jwhitham/spdif-bit-exactness-tools/img/diagram1.jpg

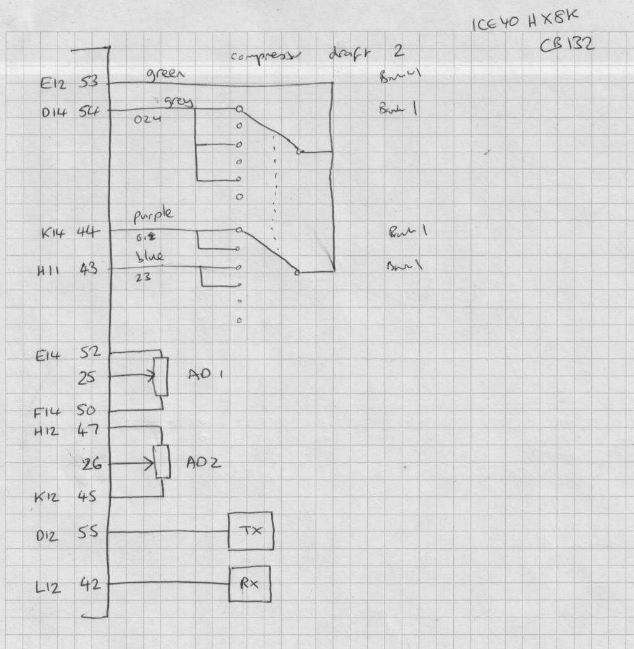
img/diagram1.jpg
