jwhitham/spdif-bit-exactness-tools/img/diagram2.jpg

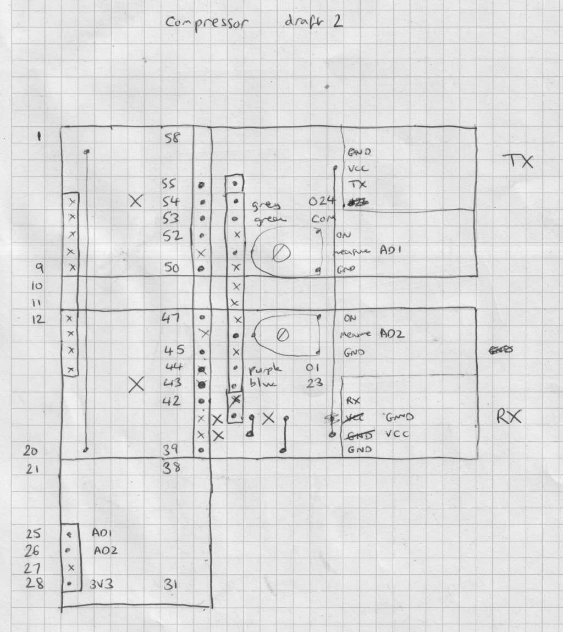
img/diagram2.jpg
