jwhitham/spdif-bit-exactness-tools/img/fpga.jpg

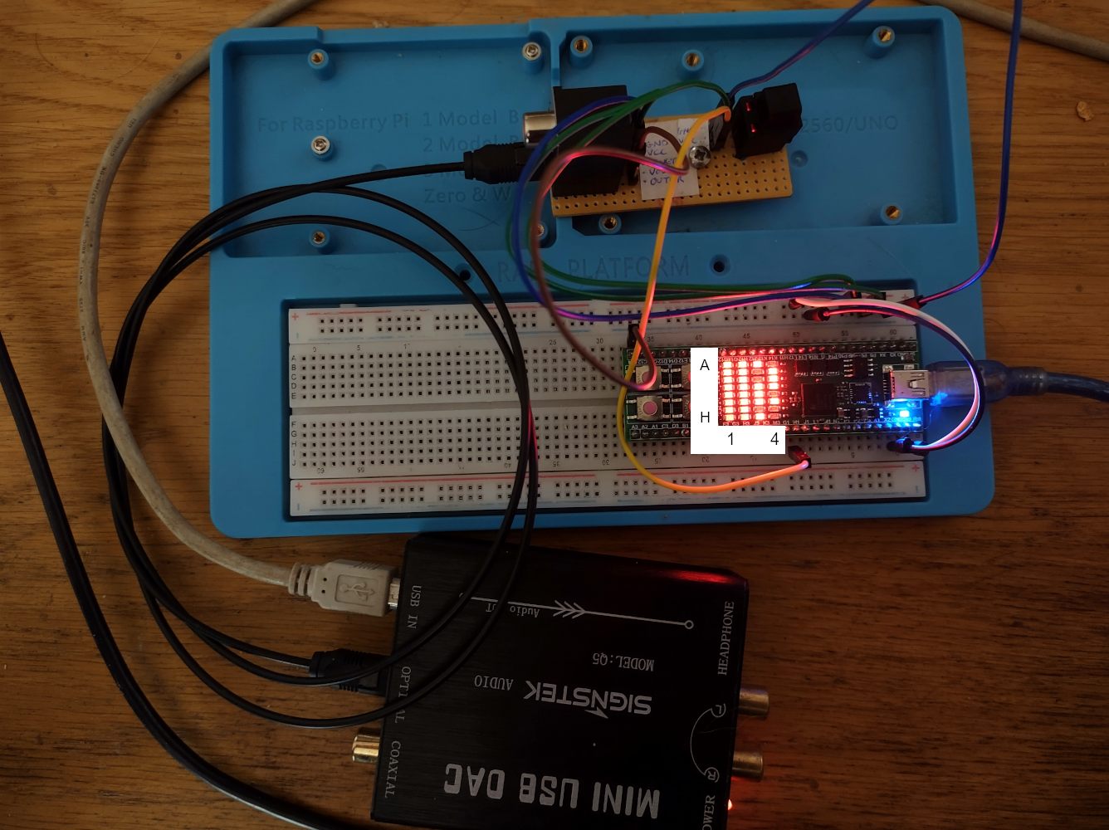
img/fpga.jpg
