jwhitham/spdif-bit-exactness-tools/fpga/test/test_top_level_out.txt

Start of ../examples/20220502-32k.csv
second matcher desynchronised
second channel decoder desynchronised
second packet decoder desynchronised
second input decoder desynchronised
combined encoder desynchronised
clock regenerator desynchronised
matcher desynchronised
channel decoder desynchronised
packet decoder desynchronised
input decoder desynchronised
input decoder single time = 0
input decoder synchronised
input decoder single time = 44
packet decoder synchronised
input decoder desynchronised
input decoder single time = 0
packet decoder desynchronised
input decoder synchronised
input decoder single time = 12
packet decoder synchronised
packet decoder desynchronised
packet decoder synchronised
channel decoder synchronised
000000 cfb500
input decoder desynchronised
input decoder single time = 0
packet decoder desynchronised
channel decoder desynchronised
Start of ../examples/20220502-44k.csv
input decoder synchronised
input decoder single time = 40
packet decoder synchronised
input decoder desynchronised
input decoder single time = 0
packet decoder desynchronised
input decoder synchronised
input decoder single time = 9
packet decoder synchronised
packet decoder desynchronised
input decoder desynchronised
input decoder single time = 0
Start of ../examples/20220502-48k.csv
input decoder synchronised
input decoder single time = 40
packet decoder synchronised
input decoder desynchronised
input decoder single time = 0
packet decoder desynchronised
input decoder synchronised
input decoder single time = 8
packet decoder synchronised
channel decoder synchronised
000000 000000
000000 000000
input decoder desynchronised
input decoder single time = 0
packet decoder desynchronised
channel decoder desynchronised
Start of ../examples/test_48000_24_bit.csv
input decoder synchronised
input decoder single time = 39
packet decoder synchronised
input decoder desynchronised
input decoder single time = 0
packet decoder desynchronised
input decoder synchronised
input decoder single time = 6
packet decoder synchronised
packet decoder desynchronised
input decoder desynchronised
input decoder single time = 0
input decoder synchronised
input decoder single time = 9
packet decoder synchronised
channel decoder synchronised
001000 ffefff
002000 ffdfff
004000 ffbfff
008000 ff7fff
010000 feffff
020000 fdffff
040000 fbffff
080000 f7ffff
clock regenerator synchronised
combined encoder synchronised
100000 efffff
second input decoder synchronised
second packet decoder synchronised
second input decoder desynchronised
second packet decoder desynchronised
200000 dfffff
second input decoder synchronised
second packet decoder synchronised
second channel decoder synchronised
400000 bfffff
800000 7fffff
01e000 654321
c64e00 655e00
257600 7d5600
f66900 51f300
b61800 1d7600
4dc100 db5e00
40d900 9e0d00
508a00 48dd00
e3b30d 0c8faf
afe65e 4195b3
667001 40817f
24daf1 ebf8c9
5a20c9 75c3ea
d0961c 8de3b3
8fb408 cfb555
ea6d66 3e4874
000001 fffffe
000002 fffffd
000004 fffffb
000008 fffff7
000010 ffffef
000020 ffffdf
000040 ffffbf
000080 ffff7f
000100 fffeff
000200 fffdff
000400 fffbff
000800 fff7ff
001000 ffefff
002000 ffdfff
004000 ffbfff
008000 ff7fff
010000 feffff
input decoder desynchronised
input decoder single time = 0
packet decoder desynchronised
channel decoder desynchronised
clock regenerator desynchronised
combined encoder desynchronised
second input decoder desynchronised
second packet decoder desynchronised
second channel decoder desynchronised
Start of ../examples/test_44100_24_bit.csv
input decoder synchronised
input decoder single time = 39
packet decoder synchronised
input decoder desynchronised
input decoder single time = 0
packet decoder desynchronised
input decoder synchronised
input decoder single time = 7
input decoder single time = 9
packet decoder synchronised
channel decoder synchronised
020000 db5e00
40d900 9e0d00
508a00 48dd00
e3b30d 0c8faf
afe65e 4195b3
667001 40817f
24daf1 ebf8c9
5a20c9 75c3ea
clock regenerator synchronised
d0961c 8de3b3
combined encoder synchronised
8fb408 cfb555
second input decoder synchronised
second packet decoder synchronised
second input decoder desynchronised
second packet decoder desynchronised
ea6d66 3e4874
second input decoder synchronised
second packet decoder synchronised
second channel decoder synchronised
000001 fffffe
000002 fffffd
000004 fffffb
000008 fffff7
000010 ffffef
000020 ffffdf
000040 ffffbf
000080 ffff7f
000100 fffeff
000200 fffdff
000400 fffbff
000800 fff7ff
001000 ffefff
002000 ffdfff
004000 ffbfff
008000 ff7fff
010000 feffff
020000 fdffff
040000 fbffff
080000 f7ffff
100000 efffff
200000 dfffff
400000 bfffff
800000 7fffff
01b900 654321
c64e00 655e00
257600 7d5600
f66900 51f300
b61800 1d7600
input decoder desynchronised
input decoder single time = 0
packet decoder desynchronised
channel decoder desynchronised
clock regenerator desynchronised
combined encoder desynchronised
second input decoder desynchronised
second packet decoder desynchronised
second channel decoder desynchronised
Start of test/test_44100_data with quality = Quality.EXACT_24
input decoder synchronised
input decoder single time = 41
packet decoder synchronised
input decoder single time = 40
input decoder desynchronised
input decoder single time = 0
packet decoder desynchronised
input decoder synchronised
input decoder single time = 8
packet decoder synchronised
channel decoder synchronised
000004 fffffb
000008 fffff7
000010 ffffef
000020 ffffdf
000040 ffffbf
000080 ffff7f
000100 fffeff
000200 fffdff
clock regenerator synchronised
combined encoder synchronised
000400 fffbff
second input decoder synchronised
second packet decoder synchronised
second input decoder desynchronised
second packet decoder desynchronised
000800 fff7ff
second input decoder synchronised
second packet decoder synchronised
second channel decoder synchronised
001000 ffefff
002000 ffdfff
004000 ffbfff
008000 ff7fff
010000 feffff
020000 fdffff
040000 fbffff
080000 f7ffff
100000 efffff
200000 dfffff
400000 bfffff
800000 7fffff
01b900 654321
c64e00 655e00
257600 7d5600
f66900 51f300
b61800 1d7600
4dc100 db5e00
40d900 9e0d00
508a00 48dd00
e3b30d 0c8faf
afe65e 4195b3
667001 40817f
24daf1 ebf8c9
5a20c9 75c3ea
d0961c 8de3b3
8fb408 cfb555
ea6d66 3e4874
000001 fffffe
000002 fffffd
000004 fffffb
000008 fffff7
000010 ffffef
000020 ffffdf
000040 ffffbf
000080 ffff7f
000100 fffeff
000200 fffdff
000400 fffbff
000800 fff7ff
001000 ffefff
002000 ffdfff
004000 ffbfff
008000 ff7fff
010000 feffff
020000 fdffff
040000 fbffff
080000 f7ffff
100000 efffff
200000 dfffff
400000 bfffff
800000 7fffff
matcher sample rate = 44100 sync4 = 3
matcher synchronised
second matcher synchronised
01b900 654321
c64e00 655e00
257600 7d5600
f66900 51f300
b61800 1d7600
4dc100 db5e00
40d900 9e0d00
508a00 48dd00
e3b30d 0c8faf
afe65e 4195b3
667001 40817f
24daf1 ebf8c9
5a20c9 75c3ea
d0961c 8de3b3
8fb408 cfb555
ea6d66 3e4874
000001 fffffe
000002 fffffd
000004 fffffb
000008 fffff7
000010 ffffef
000020 ffffdf
000040 ffffbf
000080 ffff7f
000100 fffeff
000200 fffdff
000400 fffbff
000800 fff7ff
001000 ffefff
002000 ffdfff
004000 ffbfff
008000 ff7fff
010000 feffff
020000 fdffff
040000 fbffff
080000 f7ffff
100000 efffff
200000 dfffff
400000 bfffff
800000 7fffff
01b900 654321
c64e00 655e00
257600 7d5600
f66900 51f300
b61800 1d7600
4dc100 db5e00
40d900 9e0d00
508a00 48dd00
e3b30d 0c8faf
afe65e 4195b3
667001 40817f
24daf1 ebf8c9
5a20c9 75c3ea
d0961c 8de3b3
8fb408 cfb555
ea6d66 3e4874
000001 fffffe
000002 fffffd
000004 fffffb
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
second packet decoder desynchronised
second input decoder desynchronised
combined encoder desynchronised
clock regenerator desynchronised
matcher desynchronised
channel decoder desynchronised
packet decoder desynchronised
input decoder single time = 0
input decoder desynchronised
