jwhitham/spdif-bit-exactness-tools/examples/test_44100_24_bit.csv

Time | Channel A
(ms) | (mV)
-0.00020594 | 64.21705000
-0.00012594 | 3.17697700
-0.00004594 | -5.79851700
0.00003406 | 50.75228000
0.00011406 | 63.31981000
0.00019406 | 65.11430000
0.00027406 | 64.21705000
0.00035406 | 43.56823000
0.00043406 | -2.20954000
0.00051406 | -5.79851700
0.00059406 | -6.69576100
0.00067406 | -8.49330100
0.00075406 | 53.44401000
0.00083406 | 64.21705000
0.00091406 | 64.21705000
0.00099406 | 64.21705000
0.00107406 | 23.81970000
0.00115406 | -5.79851700
0.00123406 | -3.10678400
0.00131406 | 60.62502000
0.00139406 | 64.21705000
0.00147406 | 2.27973300
0.00155406 | -5.79851700
0.00163406 | -6.69576100
0.00171406 | -7.59605700
0.00179406 | 35.48997000
0.00187406 | 63.31981000
0.00195406 | 65.11430000
0.00203406 | 65.11430000
0.00211406 | 65.11430000
0.00219406 | 65.11430000
0.00227406 | 65.11430000
0.00235406 | 3.17697700
0.00243406 | -5.79851700
0.00251406 | -6.69576100
0.00259406 | -7.59605700
0.00267406 | -7.59605700
0.00275406 | -7.59605700
0.00283406 | 13.94696000
0.00291406 | 60.62502000
0.00299406 | 64.21705000
0.00307406 | -3.10678400
0.00315406 | -5.79851700
0.00323406 | 53.44401000
0.00331406 | 64.21705000
0.00339406 | 65.11430000
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
