jwhitham/spdif-bit-exactness-tools/fpga/app/rotary_switch.vhdl

-- Decode a 6-way double pole rotary switch which can be overridden by buttons.
-- The rotary switch
-- to obtain a number from 000 to 101.
-- Buttons may also be used to temporarily override the rotary switch.

library work;
use work.all;

library ieee;
use ieee.std_logic_1164.all;
use ieee.numeric_std.all;

entity rotary_switch is
    port (
        clock_in            : in std_logic;
        reset_in            : in std_logic;
        pulse_100hz_in      : in std_logic;
        rotary_024          : in std_logic; -- grey wire
        rotary_01           : in std_logic; -- purple wire
        rotary_23           : in std_logic; -- blue wire
        left_button         : in std_logic;
        right_button        : in std_logic;
        strobe_out          : out std_logic := '0';
        value_out           : out mode_definitions.t_mode := mode_definitions.min_value;
        com_mode_value_in   : in mode_definitions.t_mode;
        com_mode_set_in     : in std_logic;
        com_mode_clear_in   : in std_logic);
end rotary_switch;

architecture structural of rotary_switch is

    -- Signals must be stable for 10 - 20ms to be recognised as valid
    constant max_countdown  : Natural := 2;
    subtype t_countdown is Natural range 0 to max_countdown;
    subtype t_button is std_logic_vector (1 downto 0);

    -- Registers
    signal countdown        : t_countdown := max_countdown;
    signal code             : std_logic_vector (2 downto 0) := (others => '0');
    signal updated_buttons  : std_logic := '0';
    signal updated_rotary   : std_logic := '0';
    signal new_button_value : t_button := "00";
    signal new_rotary_value : mode_definitions.t_mode := mode_definitions.min_value;
    signal old_button_value : t_button := "00";
    signal old_rotary_value : mode_definitions.t_mode := mode_definitions.min_value;
    signal output_value     : mode_definitions.t_mode := mode_definitions.min_value;

    -- Signals

begin
    register_inputs : process (clock_in)
    begin
        if clock_in'event and clock_in = '1' then
            code (0) <= rotary_024;
            code (1) <= rotary_01;
            code (2) <= rotary_23;
            new_button_value (1) <= not left_button;   -- buttons are active low
            new_button_value (0) <= not right_button;
        end if;
    end process register_inputs;

    decode_inputs : process (clock_in)
    begin
        if clock_in'event and clock_in = '1' then
            case code is
                when "100" =>  new_rotary_value <= mode_definitions.COMPRESS_MAX; -- rotary_01 low: rotary_value is 0
                when "101" =>  new_rotary_value <= mode_definitions.COMPRESS_2;   --                rotary_value is 1
                when "010" =>  new_rotary_value <= mode_definitions.COMPRESS_1;   -- rotary_23 low: rotary_value is 2
                when "011" =>  new_rotary_value <= mode_definitions.ATTENUATE_2;  --                rotary_value is 3
                when "110" =>  new_rotary_value <= mode_definitions.COMPRESS_VIDEO; -- 01 / 23 high:rotary_value is 4
                when "111" =>  new_rotary_value <= mode_definitions.PASSTHROUGH;  --                rotary_value is 5
                when others => new_rotary_value <= mode_definitions.PASSTHROUGH;  -- invalid (both 01 and 23 are low)
            end case;
        end if;
    end process decode_inputs;

    await_stability : process (clock_in)
    begin
        if clock_in'event and clock_in = '1' then
            strobe_out <= '0';

            if reset_in = '1' then
                -- Don't trigger a mode change strobe when coming out of reset!
                -- Start up in the mode selected with the switch.
                updated_buttons <= '0';
                updated_rotary <= '0';
                old_button_value <= new_button_value;
                old_rotary_value <= new_rotary_value;
                output_value <= new_rotary_value;
                countdown <= max_countdown;

            elsif new_button_value /= old_button_value then
                countdown <= max_countdown;
                updated_buttons <= '1';
                old_button_value <= new_button_value;

            elsif new_rotary_value /= old_rotary_value then
                countdown <= max_countdown;
                updated_rotary <= '1';
                old_rotary_value <= new_rotary_value;

            elsif countdown /= 0 then
                if pulse_100hz_in = '1' then
                    countdown <= countdown - 1;
                end if;

            else
                if updated_buttons = '1' then
                    if new_button_value (1) = '1' then
                        -- left button: decrement
                        strobe_out <= '1';
                        if output_value /= mode_definitions.min_value then
                            output_value <= std_logic_vector (unsigned (output_value) - 1);
                        end if;
                    elsif new_button_value (0) = '1' then
                        -- right button: increment
                        strobe_out <= '1';
                        if output_value /= mode_definitions.max_value then
                            output_value <= std_logic_vector (unsigned (output_value) + 1);
                        end if;
                    end if;
                    updated_buttons <= '0';
                elsif updated_rotary = '1' or com_mode_clear_in = '1' then
                    -- go direct to current setting on the rotary switch
                    strobe_out <= '1';
                    output_value <= new_rotary_value;
                    updated_rotary <= '0';
                elsif com_mode_set_in = '1' then
                    -- Remote control set
                    strobe_out <= '1';
                    output_value <= com_mode_value_in;
                end if;
            end if;
        end if;
    end process await_stability;

    value_out <= output_value;

end architecture structural;
