jwhitham/spdif-bit-exactness-tools/fpga/comfilter/banked_shift_register.vhdl

library comfilter;
use comfilter.all;

library ieee;
use ieee.std_logic_1164.all;
use ieee.numeric_std.all;

use debug_textio.all;

entity banked_shift_register is
    generic (
        name          : String;
        size          : Natural;
        verbose_debug : Boolean := false);
    port (
        reg_out             : out std_logic := '0';
        negative_out        : out std_logic := '0';
        debug_out           : out std_logic_vector(size - 1 downto 0) := (others => '0');
        shift_right_in      : in std_logic := '0';
        bank_select_in      : in std_logic := '0';
        reg_in              : in std_logic := '0';
        clock_in            : in std_logic := '0');
end banked_shift_register;

architecture structural of banked_shift_register is
    signal reg_b0, negative_b0, shift_b0 : std_logic := '0';
    signal reg_b1, negative_b1, shift_b1 : std_logic := '0';
    signal debug_b0, debug_b1            : std_logic_vector(size - 1 downto 0) := (others => '0');
begin
    b0 : entity shift_register
        generic map (
            name => name & "_b0",
            size => size,
            verbose_debug => verbose_debug)
        port map (
            reg_out => reg_b0,
            negative_out => negative_b0,
            shift_right_in => shift_b0,
            debug_out => debug_b0,
            reg_in => reg_in,
            clock_in => clock_in);

    b1 : entity shift_register
        generic map (
            name => name & "_b1",
            size => size,
            verbose_debug => verbose_debug)
        port map (
            reg_out => reg_b1,
            negative_out => negative_b1,
            shift_right_in => shift_b1,
            debug_out => debug_b1,
            reg_in => reg_in,
            clock_in => clock_in);

    reg_out <= reg_b0 when bank_select_in = '0' else reg_b1;
    negative_out <= negative_b0 when bank_select_in = '0' else negative_b1;
    shift_b0 <= shift_right_in when bank_select_in = '0' else '0';
    shift_b1 <= shift_right_in when bank_select_in = '1' else '0';
    debug_out <= debug_b0 when bank_select_in = '0' else debug_b1;
end structural;
