jwhitham/spdif-bit-exactness-tools/fpga/test/test_compressor_main.vhdl

library work;
use work.all;

library ieee;
use ieee.std_logic_1164.all;
use ieee.numeric_std.all;

use debug_textio.all;

entity test_compressor_main is
end test_compressor_main;

architecture structural of test_compressor_main is

    signal clock           : std_logic := '0';
    signal raw_data        : std_logic := '0';
    signal done            : std_logic := '0';
    constant one           : std_logic := '1';
    constant zero          : std_logic := '0';
    signal lcols           : std_logic_vector (3 downto 0) := (others => '0');
    signal lrows           : std_logic_vector (7 downto 0) := (others => '0');

begin
    test_signal_gen : entity test_signal_generator
        port map (raw_data_out => raw_data, done_out => done, clock_out => clock);

    t : entity compressor_main
        port map (
            clock_in => clock,
            spdif_rx_in => raw_data,
            lcols_out => lcols,
            lrows_out => lrows,
            rx_from_pic_in => zero,
            rotary_024_in => one,
            rotary_01_in => one,
            rotary_23_in => one,
            button_a11_in => one,
            button_c11_in => one,
            button_c6_in => one,
            button_a5_in => one);

    printer : process
        variable l : line;

        procedure dump is
        begin
            for i in 0 to 7 loop
                if lrows (i) = '1' then
                    write (l, String'("#"));
                else
                    write (l, String'("."));
                end if;
            end loop;
            writeline (output, l);
        end dump;
    begin
        wait until clock'event and clock = '1';
        while done /= '1' loop
            case lcols is
                when "1110" =>
                    write (l, String'("raw left:  "));
                    dump;
                when "1101" =>
                    write (l, String'("raw right: "));
                    dump;
                when "1011" =>
                    write (l, String'("cmp left:  "));
                    dump;
                when "0111" =>
                    write (l, String'("cmp right: "));
                    dump;
                when others =>
                    null;
            end case;
            wait until lcols'event or done = '1';
        end loop;
        wait;
    end process printer;

end structural;
