jwhitham/spdif-bit-exactness-tools/fpga/test/test_encoder.vhdl

library work;
use work.all;

library ieee;
use ieee.std_logic_1164.all;
use ieee.numeric_std.all;
use ieee.math_real.all;

use debug_textio.all;

entity test_encoder is
end test_encoder;

architecture test of test_encoder is

    constant num_tests : Natural := 2;

    signal clock_in                 : std_logic := '0';
    signal done                     : std_logic_vector (0 to num_tests) := (others => '0');
    subtype t_pulse_length is std_logic_vector (1 downto 0);
    subtype t_data is std_logic_vector (31 downto 0);

    constant disable                : std_logic := '0';
    constant enable                 : std_logic := '1';

    constant num_sub_tests          : Natural := 1000;
    constant single_time            : Time := 4 us;
    constant packet_time            : Time := single_time * 64;



    function generate_test_data (index : Natural; left : Boolean) return t_data is
        variable data : t_data;
    begin
        data := (others => '0');
        data (11 downto 4) := std_logic_vector (to_unsigned (index mod 256, 8));
        data ((index mod 16) + 12) := '1';
        if not left then
            data (((index + 1) mod 16) + 12) := '1';
        end if;
        return data;
    end generate_test_data;

begin

    -- 1MHz clock (one clock every 1000ns)
    process
    begin
        done (0) <= '1';
        while done (num_tests) = '0' loop
            clock_in <= '1';
            wait for 500 ns;
            clock_in <= '0';
            wait for 500 ns;
        end loop;
        wait;
    end process;

    scenario : for test in 1 to 2 generate

        signal middle_data              : std_logic := '0';
        signal start_data               : std_logic := '0';

        signal enc_data                 : t_data := (others => '0');
        signal enc_left_strobe          : std_logic := '0';
        signal enc_right_strobe         : std_logic := '0';

        signal dec_packet_data          : std_logic := '0';
        signal dec_packet_shift         : std_logic := '0';
        signal dec_packet_start         : std_logic := '0';
        signal dec_pulse_length         : t_pulse_length := "00";
        signal dec_data                 : t_data := (others => '0');
        signal dec_left_strobe          : std_logic := '0';
        signal dec_right_strobe         : std_logic := '0';

        signal sync                     : std_logic_vector (7 downto 1) := (others => '0');
        signal oe_error                 : std_logic := '0';
        signal rg_strobe                : std_logic := '0';
        signal encoded_spdif            : std_logic := '0';

    begin

        -- S/PDIF clock strobe generated by a model of clock_regenerator
        simplified : if test = 1 generate
        begin
            spdif_pulses : process
            begin
                while done (test) = '0' loop
                    rg_strobe <= '1';
                    wait for 1 us;
                    rg_strobe <= '0';
                    wait for single_time - 1 us;
                end loop;
                wait;
            end process spdif_pulses;
            sync (2) <= sync (1);
        end generate simplified;

        -- S/PDIF clock strobe generated by clock_regenerator
        integration : if test = 2 generate
            signal pulse_length_in  : std_logic_vector (1 downto 0) := "00";
        begin
            pulse_length_sync : process
            begin
                while done (test) = '0' loop
                    -- Generate THREE pulse
                    pulse_length_in <= "11";
                    wait for 1 us;
                    pulse_length_in <= "00";
                    wait for (single_time * 3) - 1 us;

                    -- Generate fake header for the benefit of clock_regenerator
                    -- (looking to ignore a second THREE pulse)
                    for i in 1 to 5 loop
                        pulse_length_in <= "01";
                        wait for 1 us;
                        pulse_length_in <= "00";
                        wait for single_time - 1 us;
                    end loop;

                    -- here is the rest of the packet 
                    wait for single_time * 56;
                end loop;
                wait;
            end process pulse_length_sync;

            cg : entity clock_regenerator
                port map (
                    pulse_length_in => pulse_length_in,
                    clock_interval_out => open,
                    sync_in => sync (1),
                    sync_out => sync (2),
                    clock_in => clock_in,
                    spdif_clock_strobe_out => rg_strobe);

        end generate integration;

        sync (4) <= sync (3);

        ce : entity combined_encoder
            port map (clock_in => clock_in,
                      sync_in => sync (2),
                      sync_out => sync (3),
                      error_out => oe_error,
                      spdif_clock_strobe_in => rg_strobe,
                      data_out => encoded_spdif,
                      preemph_in => disable,
                      data_in => enc_data,
                      left_strobe_in => enc_left_strobe,
                      right_strobe_in => enc_right_strobe);

        id : entity input_decoder
            port map (data_in => encoded_spdif,
                      pulse_length_out => dec_pulse_length,
                      single_time_out => open,
                      enable_123_check_in => enable,
                      sync_in => sync (1),
                      sync_out => sync (5),
                      clock_in => clock_in);

        pd : entity packet_decoder
            port map (clock => clock_in,
                      pulse_length_in => dec_pulse_length,
                      sync_in => sync (5),
                      sync_out => sync (6),
                      data_out => dec_packet_data,
                      start_out => dec_packet_start,
                      shift_out => dec_packet_shift);

        cd : entity channel_decoder 
            port map (clock => clock_in,
                      data_in => dec_packet_data,
                      shift_in => dec_packet_shift,
                      start_in => dec_packet_start,
                      sync_in => sync (6),
                      sync_out => sync (7),
                      data_out => dec_data,
                      subcode_out => open,
                      left_strobe_out => dec_left_strobe,
                      right_strobe_out => dec_right_strobe);

        sync_check : process
            variable l : line;
        begin
            while done (test) = '0' loop
                wait until sync'event or done (test)'event;
                if start_data = '1' then
                    assert sync (2) = '1';
                    assert sync (3) = '1';
                    assert sync (5) = '1';
                    assert sync (6) = '1';
                    assert sync (7) = '1';
                end if;
            end loop;
            wait;
        end process sync_check;

        activity_counters : process
            variable dec_pulse_count : Natural := 0;
            variable dec_packet_count : Natural := 0;
            variable l : line;
        begin
            while done (test) = '0' loop
                wait until dec_pulse_length'event or dec_packet_start'event
                            or done (test)'event;
                if middle_data = '1' then
                    if dec_pulse_length'event and dec_pulse_length /= "00" then
                        dec_pulse_count := dec_pulse_count + 1;
                    end if;
                    if dec_packet_start'event and dec_packet_start = '1' then
                        dec_packet_count := dec_packet_count + 1;
                    end if;
                end if;
            end loop;
            write (l, String'("dec_pulse_count = "));
            write (l, dec_pulse_count);
            writeline (output, l);
            write (l, String'("dec_packet_count = "));
            write (l, dec_packet_count);
            writeline (output, l);
            wait;
        end process activity_counters;
                

        signal_generator : process
        begin
            -- Resetting
            done (test) <= '0';
            wait until done (test - 1) = '1';
            middle_data <= '0';
            start_data <= '0';
            sync (1) <= '0';
            enc_data <= (others => '0');
            enc_left_strobe <= '0';
            enc_right_strobe <= '0';
            wait for 10 us;
            sync (1) <= '1';

            -- Wait for clock generator to be synchronised
            for i in 1 to 100 loop
                exit when sync (2) = '1';
                wait for 100 us;
            end loop;
            assert sync (2) = '1';

            -- Send zeroes before tests begin
            for i in 0 to 9 loop
                enc_left_strobe <= '1';
                wait for 1 us;
                enc_left_strobe <= '0';
                wait for packet_time - 1 us;

                enc_right_strobe <= '1';
                wait for 1 us;
                enc_right_strobe <= '0';
                wait for packet_time - 1 us;
            end loop;

            -- Every part of the pipeline should be synchronised from this point
            start_data <= '1';

            -- Send test data
            for i in 0 to num_sub_tests - 1 loop
                -- Send left data
                enc_data <= generate_test_data (i * 2, true);
                enc_left_strobe <= '1';
                wait for 1 us;
                enc_left_strobe <= '0';
                wait for packet_time - 1 us;

                -- Send right data
                enc_data <= (others => '0');
                enc_data <= generate_test_data ((i * 2) + 1, false);
                enc_right_strobe <= '1';
                wait for 1 us;
                enc_right_strobe <= '0';
                wait for packet_time - 1 us;

                -- During steady state transmission, capture some data from within the pipeline
                if i = (num_sub_tests / 4) then
                    middle_data <= '1';
                end if;
                if i = ((3 * num_sub_tests) / 4) then
                    middle_data <= '0';
                end if;
            end loop;

            -- Send zeroes after tests
            for i in 0 to 99 loop
                enc_data <= (others => '0');
                enc_left_strobe <= '1';
                wait for 1 us;
                enc_left_strobe <= '0';
                wait for packet_time - 1 us;

                enc_right_strobe <= '1';
                wait for 1 us;
                enc_right_strobe <= '0';
                wait for packet_time - 1 us;
            end loop;

            start_data <= '0';
            done (test) <= '1';
            wait for 1 us;
            sync (1) <= '0';
            wait;
        end process signal_generator;

        assert oe_error = '0';

        output_checker : process
            variable l : line;
            variable expect_data_valid : Boolean := true;
            variable expect_data       : t_data := (others => '0');
            variable test_number       : Natural := 0;
        begin
            wait until done (test - 1) = '1';

            write (l, String'("begin test scenario "));
            write (l, test);
            writeline (output, l);

            while done (test) = '0' loop
                wait until dec_left_strobe'event
                        or dec_right_strobe'event or done (test)'event;
                if dec_left_strobe = '1' then
                    assert dec_right_strobe = '0';
                    expect_data := generate_test_data (test_number, true);
                    expect_data_valid := true;
                elsif dec_right_strobe = '1' then
                    assert dec_left_strobe = '0';
                    expect_data := generate_test_data (test_number, false);
                    expect_data_valid := true;
                else
                    expect_data_valid := false;
                end if;

                if expect_data_valid then
                    if to_integer (unsigned (dec_data (27 downto 4))) = 0 then
                        -- ignore this packet (startup/finish)
                        null;
                    else
                        -- unimportant non-audio parts of the data are ignored:
                        expect_data (31 downto 28) := dec_data (31 downto 28);
                        expect_data (3 downto 0) := dec_data (3 downto 0);

                        -- check for match
                        if dec_data /= expect_data then
                            write (l, String'("test "));
                            write (l, test_number);
                            write (l, String'(" received "));
                            if dec_left_strobe = '1' then
                                write (l, String'("left"));
                            else
                                write (l, String'("right"));
                            end if;
                            write (l, String'(" data "));
                            write (l, to_integer (unsigned (dec_data (27 downto 4))));
                            write (l, String'(" expected "));
                            write (l, to_integer (unsigned (expect_data (27 downto 4))));
                            writeline (output, l);
                        end if;
                        assert dec_data = expect_data;
                        test_number := test_number + 1;
                    end if;
                end if;
            end loop;

            for i in 1 to 7 loop
                assert sync (i) = '1';
            end loop;

            write (l, String'("completed "));
            write (l, test_number);
            write (l, String'(" tests"));
            writeline (output, l);
            assert test_number = (num_sub_tests * 2);
            wait;
        end process output_checker;

    end generate scenario;

end test;
