jwhitham/spdif-bit-exactness-tools/fpga/comfilter/filter_unit_microcode_store.test.vhdl

library ieee;
use ieee.std_logic_1164.all;
use ieee.numeric_std.all;

entity filter_unit_microcode_store is port (
        uc_data_out : out std_logic_vector (7 downto 0) := (others => '0');
        uc_addr_in  : in std_logic_vector (8 downto 0) := (others => '0');
        enable_in   : in std_logic := '0';
        clock_in    : in std_logic := '0');
end filter_unit_microcode_store;
architecture behavioural of filter_unit_microcode_store is
    subtype t_word is std_logic_vector (7 downto 0);
    type t_storage is array (0 to 511) of t_word;
    signal storage : t_storage := (
0 => "00000001",
1 => "11000100",
2 => "10000000",
3 => "01100000",
4 => "10000111",
5 => "11000010",
6 => "00100010",
7 => "00100010",
8 => "00100010",
9 => "00100010",
10 => "00100010",
11 => "00100010",
12 => "00100010",
13 => "00100010",
14 => "00100010",
15 => "00100010",
16 => "00100010",
17 => "00100010",
18 => "00100010",
19 => "00100010",
20 => "00100010",
21 => "00100000",
22 => "00100000",
23 => "00100000",
24 => "00100000",
25 => "00100000",
26 => "00100000",
27 => "00100000",
28 => "00100000",
29 => "00100000",
30 => "00100011",
31 => "00100011",
32 => "00100000",
33 => "00100000",
34 => "00100000",
35 => "00100000",
36 => "00100010",
37 => "10000000",
38 => "01100000",
39 => "01100000",
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
others => x"ff");

begin
    process (clock_in)
    begin
        if clock_in'event and clock_in = '1' then
            if enable_in = '1' then
                uc_data_out <= storage (to_integer (unsigned (uc_addr_in)));
            end if;
        end if;
    end process;
end architecture behavioural;
