jwhitham/spdif-bit-exactness-tools/(commit log)

2022-04-10 signal test
    [signal.csv]
2022-04-10 encoder and decoder
2022-04-10 improved decoding
    [20220409-0001.csv, 20220409-0002.csv, left24khz.csv, silence48k.csv]
2022-04-10 clear signal
    [signal.csv]
2022-04-10 32kHz test signal
    [signal2.csv]
2022-04-10 48kHz test signal
    [signal3.csv]
2022-04-10 48kHz test signal 24 bit
    [signal4.csv]
2022-04-10 encode 32 bit
    [signal4.csv]
2022-04-10 test output -> signal5.csv
    [signal5.csv]
2022-04-10 binary data sent ok
    [signal6.csv, signal7.csv]
2022-04-10 44.1kHz test ok
    [signal7.csv]
2022-04-24 new test pattern generator
    [left24khz.csv, signal.csv, signal2.csv, signal3.csv, signal4.csv, signal5.csv, signal6.csv, signal7.csv]
2022-04-30 avoid edge case
2022-05-03 more test data sampled at higher frequency - refactor channel decoder
    [20220502-32k.csv, 20220502-44k.csv, 20220502-48k.csv]
2022-05-15 update descriptions
    [test_44100_16_bit.csv, test_44100_24_bit.csv, test_48000_24_bit.csv]
2022-05-16 rearrange files part 1
    [20220502-32k.csv, 20220502-44k.csv, 20220502-48k.csv]
2022-05-23 channel decoder clears if desynced; LEDs should be clearer
2022-06-04 Corrections for the actual FPGA block ram implementation
    [fpga_main.vhdl, sb_ram40_4k.vhdl, test_fifo.vhdl]
2022-06-04 add output encoder
2022-06-04 output encoder starts
2022-06-04 test output encoder by feeding it back into a second decoder
2022-06-05 update fpga_main for output encoder
2022-06-05 Add to FPGA project - output encoder working
2022-06-05 automatically reset output encoder on error
2022-06-05 packet encoder added
2022-06-08 add packet encoder to test
2022-06-08 redesigned packet encoder
2022-06-11 channel encoder
2022-06-11 channel encoder rewrites headers, status bis, parity
2022-06-11 channel encoder working in hardware
2022-06-11 add buttons to experiment with effects
2022-06-18 avoid initial X state
    [sb_ram40_4k.vhdl]
2022-06-18 check for correct behaviour with large values
    [test_compressor.vhdl]
2022-06-19 correct peak level setting
    [compressor.vhdl]
2022-07-04 correct the period for the square wave
    [test_compressor.vhdl]
2022-07-08 replace feature for SW and SE buttons
2022-07-09 measure the clock cycles required to process a sample
2022-07-09 measure the maximum possible sample rate
2022-07-10 redesign divider to separate the value and the sign
    [test_divider.vhdl]
2022-07-14 add UART with test
2022-07-14 uart test project
2022-07-14 fixed uart bugs, communicates with RPi
2022-07-16 correct bug with carry output
    [test_subtractor.vhdl]
2022-07-16 show input level from A-D converters on LEDs
2022-07-16 show input level from A-D converters on LEDs better
2022-07-17 fix up rotary encoder
2022-07-18 add new display driver
2022-07-21 fixes for problems found by synplify
    [channel_decoder.vhdl, mode_display.vhdl, rotary_switch.vhdl]
2022-07-21 fix glitch when disabling compression
    [compressor.vhdl, test_disable_compressor.vhdl]
2022-07-22 multiplier and test case
2022-07-23 add reset generator and limit number of desync messages
    [compressor_main.vhdl, mode_display.vhdl, test_compressor_main.vhdl]
2022-07-23 wip new encoder
2022-07-23 combined encoder
2022-07-24 reintroduce watchdog to reset timers if pulses are too long; use more bits for calculating thresholds
    [input_decoder.vhdl]
2022-07-26 adc not working
2022-07-26 add test for the 'large maximum' failure mode
    [test_input_decoder.vhdl]
2022-07-26 remove uart reset
2022-07-26 still reset issues with adc
2022-07-26 restructure for reset issues - need to use up counters for reset
    [adc_driver.vhdl, compressor_main.vhdl, mode_display.vhdl]
2022-07-27 reset now working better
    [adc_driver.vhdl, compressor_main.vhdl]
2022-07-28 combined encoder merged
2022-07-28 end-to-end test for encoder
2022-07-29 encoder test
2022-07-30 initial combined encoder test
2022-07-30 clean up encoder test
2022-07-30 test encoder with clock_regenerator as well
2022-08-01 restructure the combined encoder
2022-08-01 in case right is received before left
2022-08-01 restructured encoder
2022-08-01 test encoder 2
2022-08-01 test encoder 2 - check error behaviour of encoder
    [test_encoder2.vhdl]
2022-08-08 bug fix relating to enabling/disabling bypass
    [compressor.vhdl]
2022-08-09 fix bug where peak_level was not reset properly
    [compressor.vhdl]
2022-08-09 fix minor display glitch
    [mode_display.vhdl]
2022-08-09 fix startup bug (wrong mode)
    [rotary_switch.vhdl]
2024-11-29 add custom textio component
    avoids non-synthesisable VHDL in non-testbench parts of the project
    [channel_decoder.vhdl, combined_encoder.vhdl, compressor.vhdl, debug_textio-body.vhdl, debug_textio.vhdl, input_decoder.vhdl, make_test_bench.py, packet_decoder.vhdl]
2024-12-21 Replace latch with register; fix bugs in new code
    add auto-reset feature
    [compressor.vhdl, compressor_main.vhdl, vu_meter.vhdl]
2024-12-22 change counter reset logic
    [compressor_main.vhdl]
2024-12-24 Allow remote control of ADC registers
2024-12-24 Sample rate independence
2024-12-25 Assume sample rate and baud rate are 48kHz
2024-12-26 baud rate derived from sample rate
2025-01-05 S/PDIF Pico project
